WGRL/split-keyboard/Img/left_printed.pdf

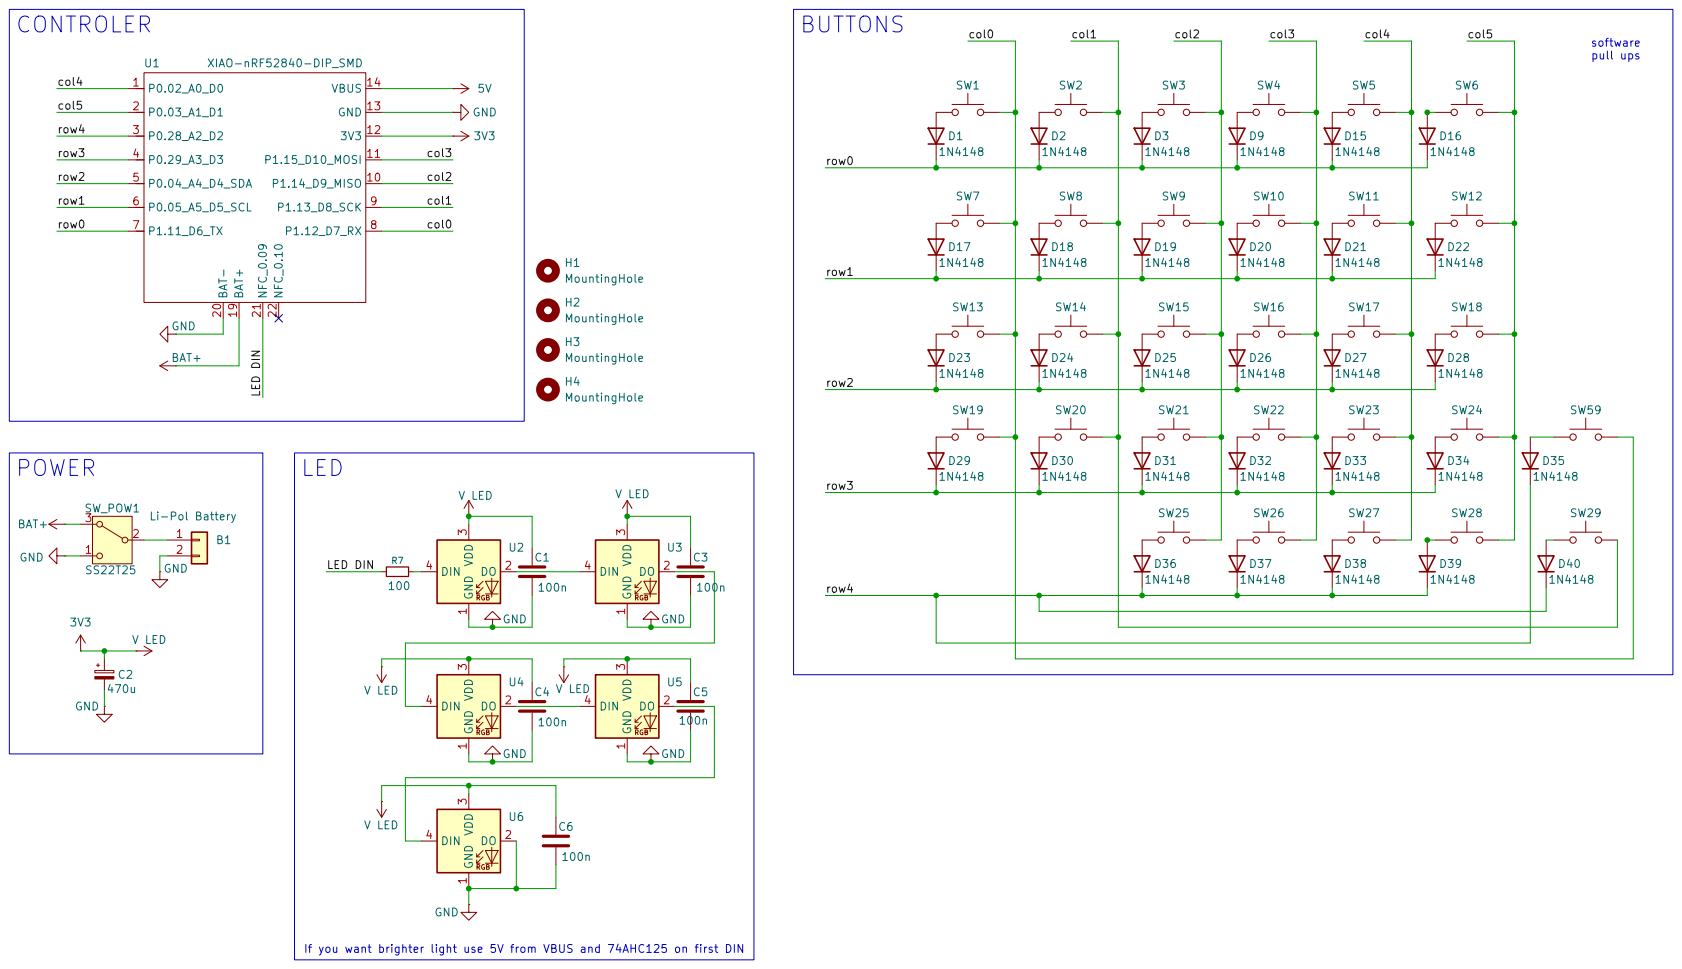
[picture p6: page 1]
