WGRL/split-keyboard/Img/right_printed.pdf

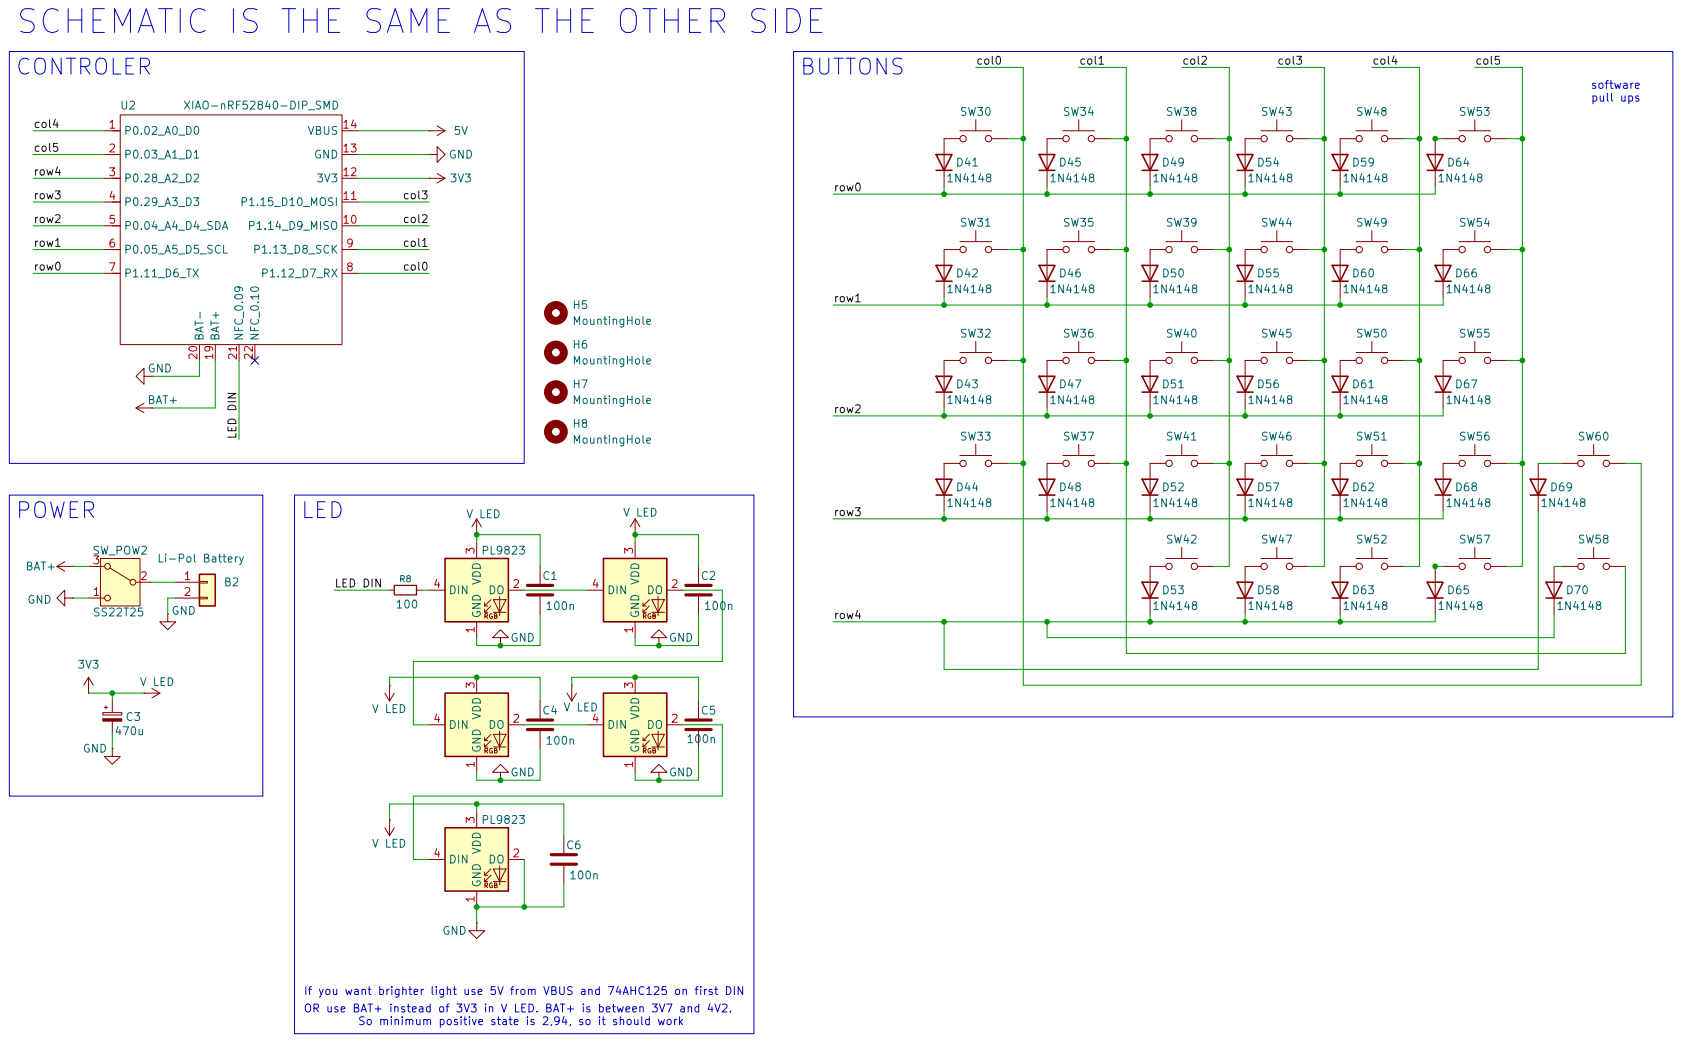
[picture p7: page 1]
