WGRL/split-keyboard/hardware_printed/right_side/right_side.kicad_pcb

## KiCad design hardware_printed/right_side/right_side.kicad_pcb (2026-10-13)

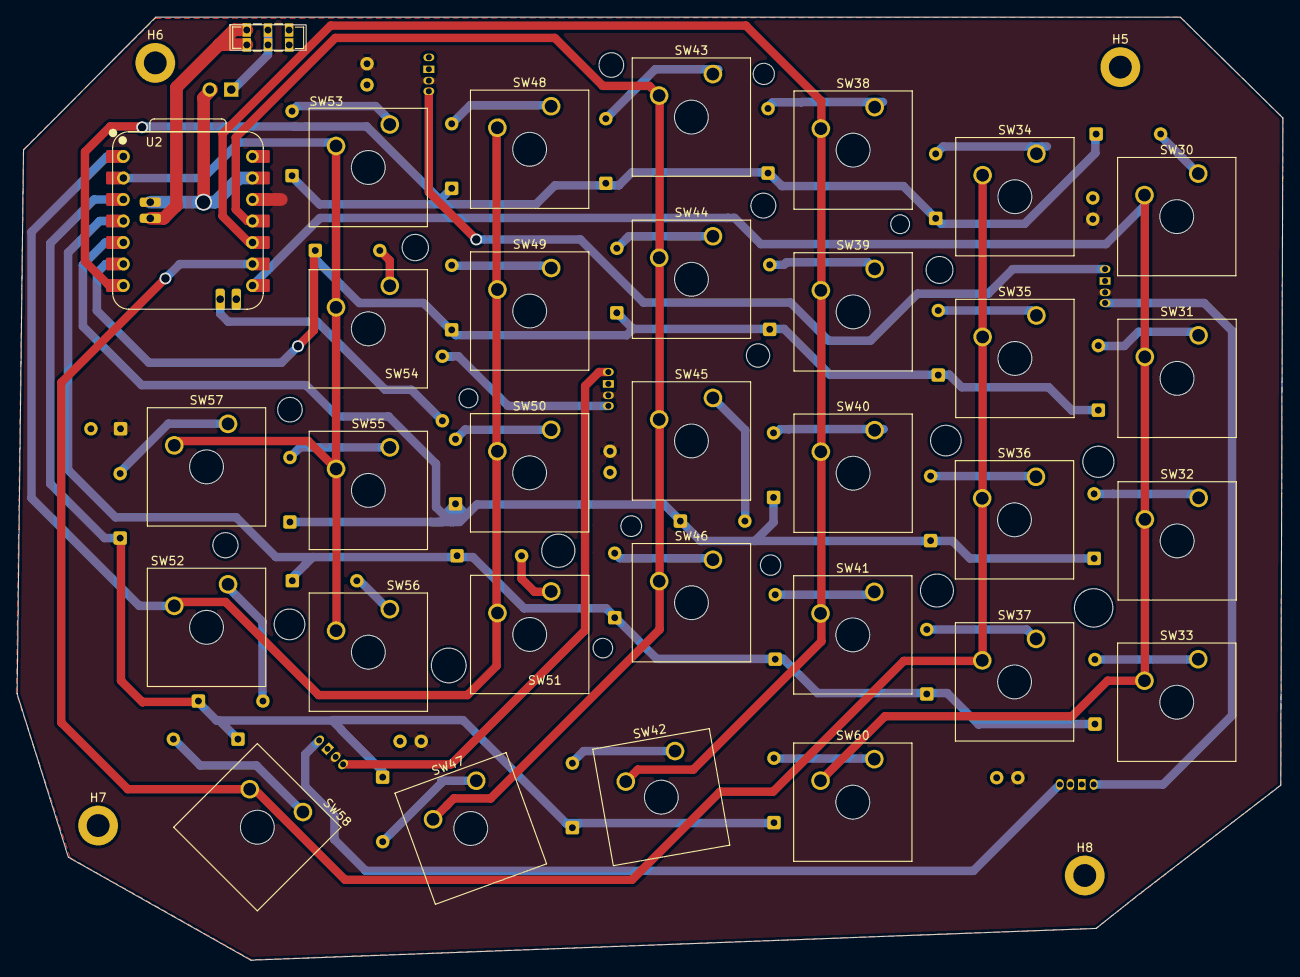
[picture p8: board right_side.kicad_pcb from above]

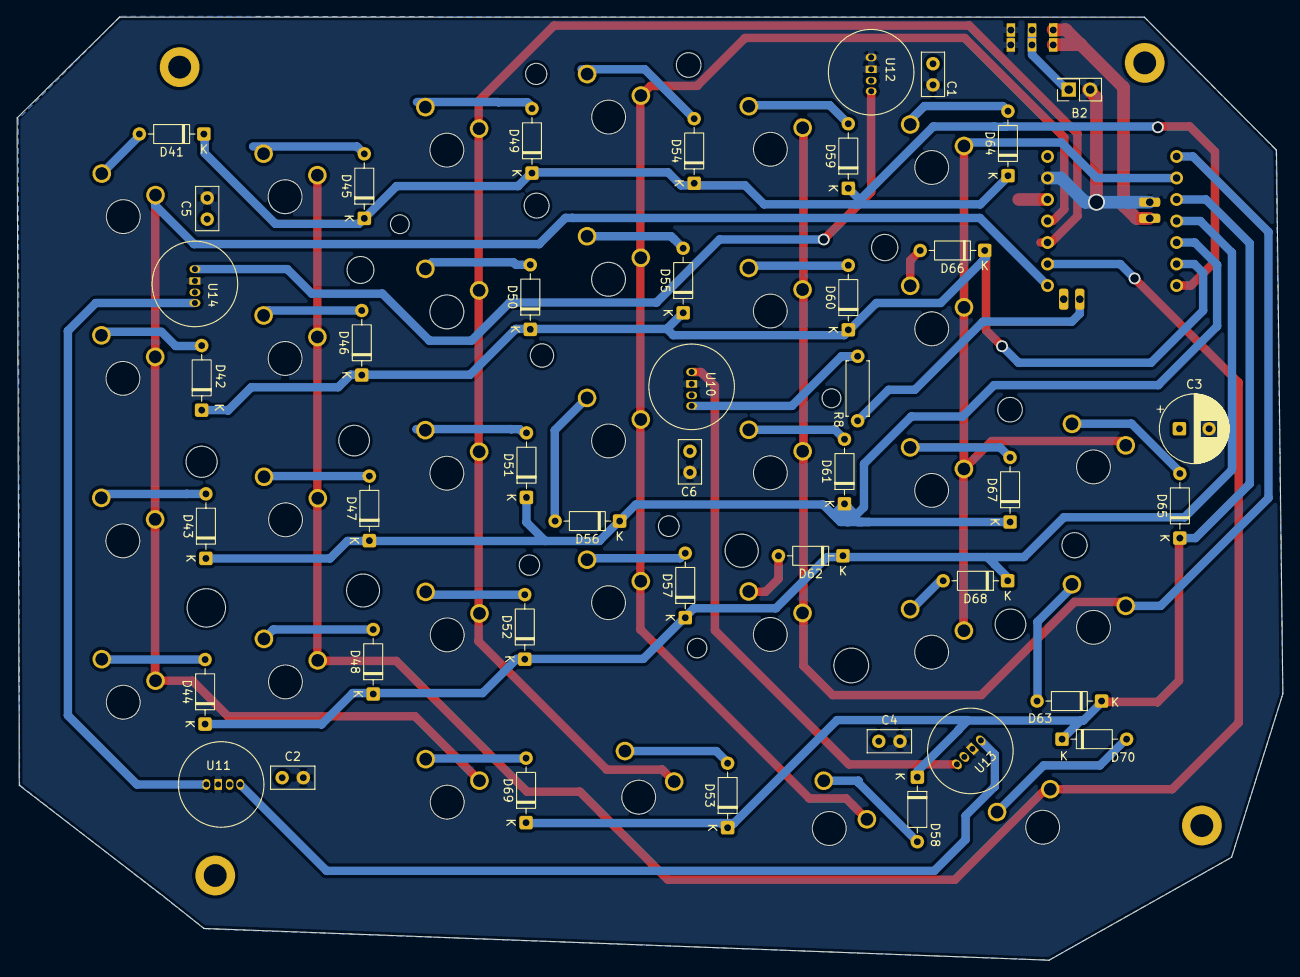
[picture p9: board right_side.kicad_pcb from below]

Board: 2 copper layers, 149.4 x 111.3 mm, 79 parts (43 on the bottom side), 51 nets.

Parts:
B2: Li-Pol Battery; PinSocket_2x01_P2.54mm_Vertical
C1, C2, C4, C5, C6: 100n; C_Disc_D5.0mm_W2.5mm_P2.50mm
C3: 470u; CP_Radial_D8.0mm_P3.50mm
D41, D42, D43, D44, D45, D46, D47, D48, D49, D50, D51, D52, D53, D54, D55, D56, D57, D58, D59, D60, D61, D62, D63, D64, D65, D66, D67, D68, D69, D70: 1N4148; D_DO-35_SOD27_P7.62mm_Horizontal
H5, H6, H7, H8: MountingHole; MountingHole_2.7mm_M2.5_DIN965_Pad
R8: 100; R_Axial_DIN0207_L6.3mm_D2.5mm_P7.62mm_Horizontal
SW30, SW31, SW32, SW33, SW34, SW35, SW36, SW37, SW38, SW39, SW40, SW41, SW42, SW43, SW44, SW45, SW46, SW47, SW48, SW49, SW50, SW51, SW52, SW53, SW54, SW55, SW56, SW57, SW58, SW60: SW_Push; SW_Cherry_MX_1.00u_Plate
SW_POW2: SS22T25; slider
U2: XIAO-nRF52840-DIP_SMD
U10, U11, U12, U13, U14: PL9823; PL9823-F8

Connections:
3V3: C1.1, C2.1, C3.1, C4.1, C5.1, C6.1, U2.12 (3V3), U10.3 (VDD), U11.3 (VDD), U12.3 (VDD), U13.3 (VDD), U14.3 (VDD)
/LED DIN: R8.1, U2.21 (NFC_0.09)
/col0: SW30.2, SW31.2, SW32.2, SW33.2, SW60.2, U2.8 (P1.12_D7_RX)
/col1: SW34.2, SW35.2, SW36.2, SW37.2, SW58.2, U2.9 (P1.13_D8_SCK)
/col2: SW38.2, SW39.2, SW40.2, SW41.2, SW42.2, U2.10 (P1.14_D9_MISO)
/col3: SW43.2, SW44.2, SW45.2, SW46.2, SW47.2, U2.11 (P1.15_D10_MOSI)
/col4: SW48.2, SW49.2, SW50.2, SW51.2, SW52.2, U2.1 (P0.02_A0_D0)
/col5: SW53.2, SW54.2, SW55.2, SW56.2, SW57.2, U2.2 (P0.03_A1_D1)
/row0: D41.1 (K), D45.1 (K), D49.1 (K), D54.1 (K), D59.1 (K), D64.1 (K), U2.7 (P1.11_D6_TX)
/row1: D42.1 (K), D46.1 (K), D50.1 (K), D55.1 (K), D60.1 (K), D66.1 (K), U2.6 (P0.05_A5_D5_SCL)
/row2: D43.1 (K), D47.1 (K), D51.1 (K), D56.1 (K), D61.1 (K), D67.1 (K), U2.5 (P0.04_A4_D4_SDA)
/row3: D44.1 (K), D48.1 (K), D52.1 (K), D57.1 (K), D62.1 (K), D68.1 (K), U2.4 (P0.29_A3_D3)
/row4: D53.1 (K), D58.1 (K), D63.1 (K), D65.1 (K), D69.1 (K), D70.1 (K), U2.3 (P0.28_A2_D2)
BAT+: SW_POW2.3 (A), U2.19 (BAT+)
GND: B2.2, C1.2, C2.2, C3.2, C4.2, C5.2, C6.2, SW_POW2.1 (C), U2.13 (GND), U2.20 (BAT-), U10.1 (GND), U11.1 (GND), U12.1 (GND), U12.2 (DO), U13.1 (GND), U14.1 (GND)
unnamed: B2.1, SW_POW2.2 (B)
unnamed: D41.2 (A), SW30.1
unnamed: D42.2 (A), SW31.1
unnamed: D43.2 (A), SW32.1
unnamed: D44.2 (A), SW33.1
unnamed: D45.2 (A), SW34.1
unnamed: D46.2 (A), SW35.1
unnamed: D47.2 (A), SW36.1
unnamed: D48.2 (A), SW37.1
unnamed: D49.2 (A), SW38.1
unnamed: D50.2 (A), SW39.1
unnamed: D51.2 (A), SW40.1
unnamed: D52.2 (A), SW41.1
unnamed: D53.2 (A), SW42.1
unnamed: D54.2 (A), SW43.1
unnamed: D55.2 (A), SW44.1
unnamed: D56.2 (A), SW45.1
unnamed: D57.2 (A), SW46.1
unnamed: D58.2 (A), SW47.1
unnamed: D59.2 (A), SW48.1
unnamed: D60.2 (A), SW49.1
unnamed: D61.2 (A), SW50.1
unnamed: D62.2 (A), SW51.1
unnamed: D63.2 (A), SW52.1
unnamed: D64.2 (A), SW53.1
unnamed: D65.2 (A), SW57.1
unnamed: D66.2 (A), SW54.1
unnamed: D67.2 (A), SW55.1
unnamed: D68.2 (A), SW56.1
unnamed: D69.2 (A), SW60.1
unnamed: D70.2 (A), SW58.1
unnamed: R8.2, U10.4 (DIN)
unnamed: U10.2 (DO), U13.4 (DIN)
unnamed: U11.4 (DIN), U13.2 (DO)
unnamed: U11.2 (DO), U14.4 (DIN)
unnamed: U12.4 (DIN), U14.2 (DO)
