WGRL/split-keyboard/hardware/left_side/left_side.kicad_sch

## KiCad design hardware/left_side/left_side.kicad_sch (2026-10-13)

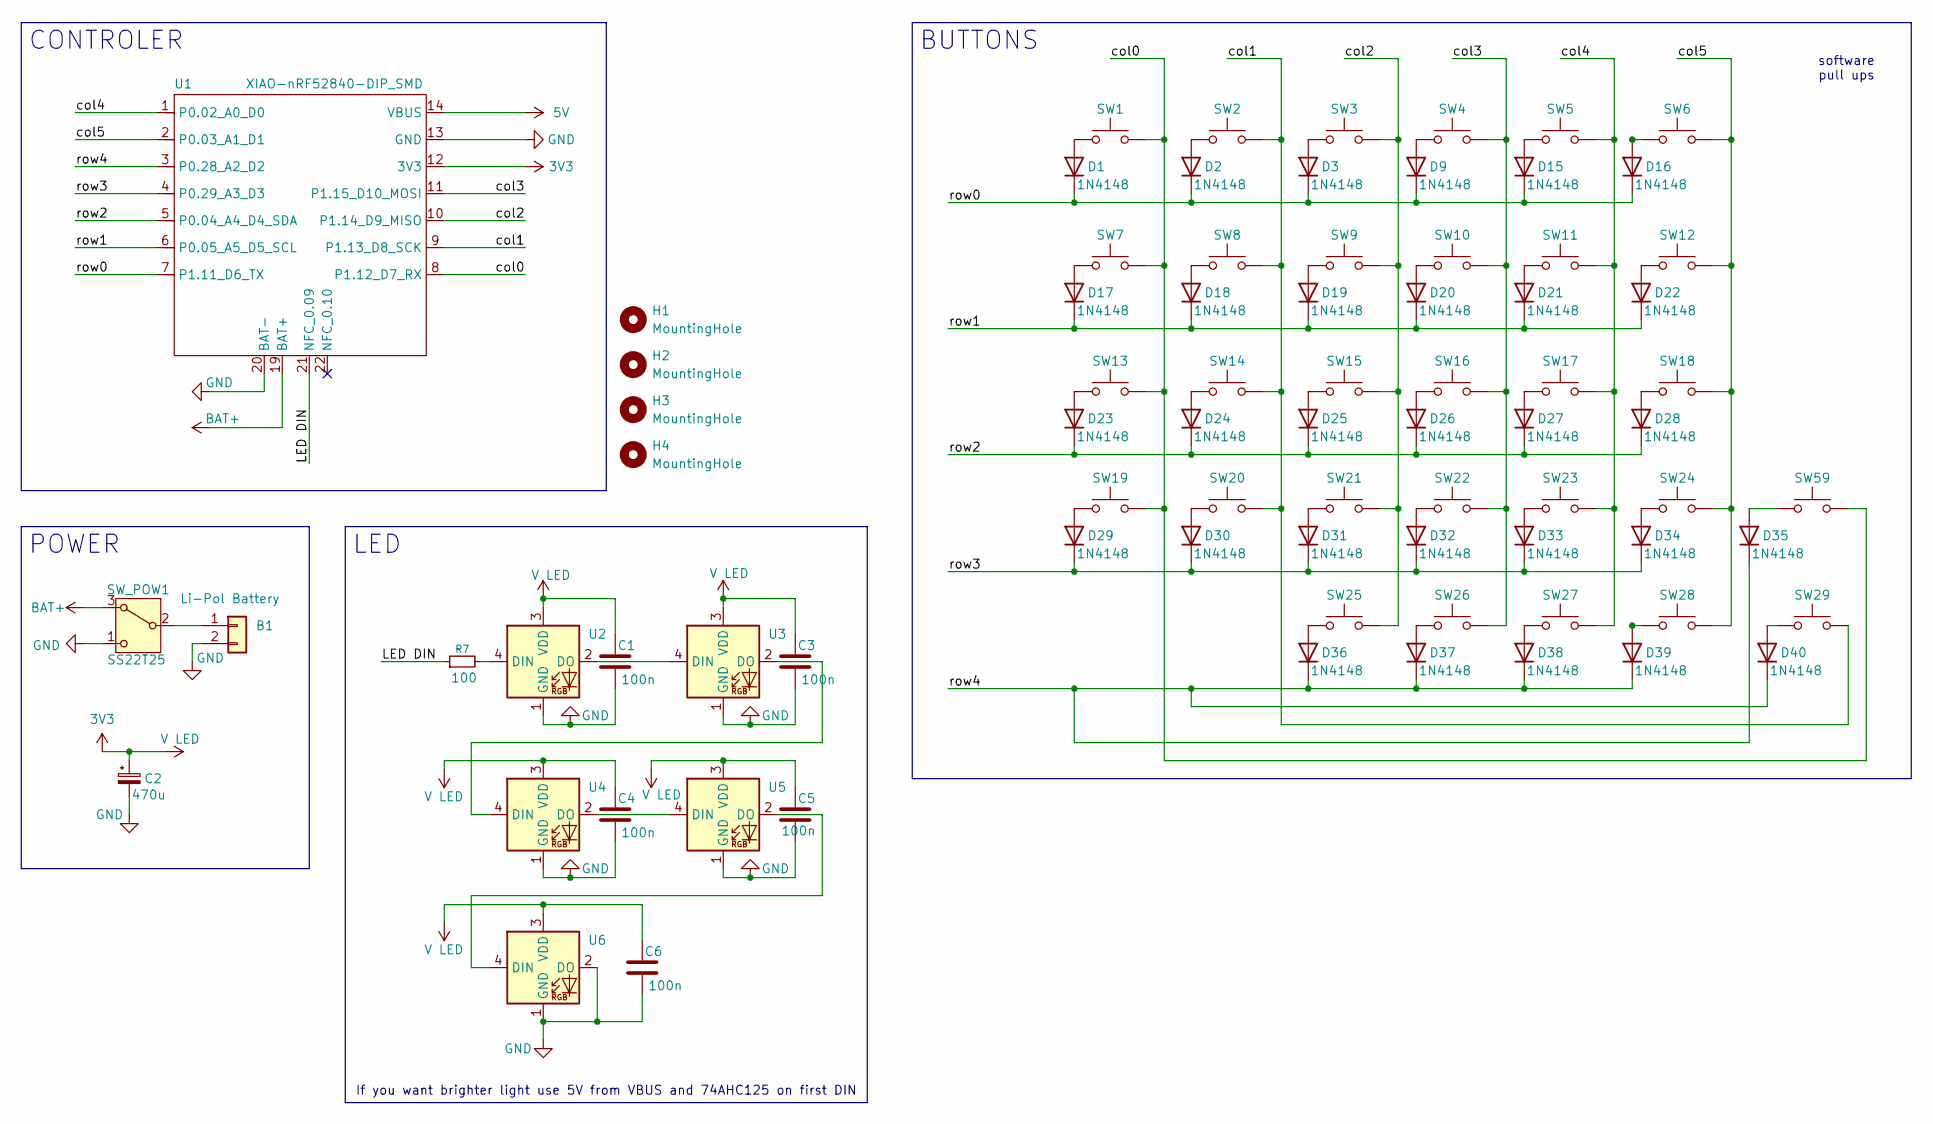
[picture p10: schematic left_side.kicad_sch]

Parts:
B1: Li-Pol Battery; PinSocket_2x01_P2.54mm_Vertical
C1, C3, C4, C5, C6: 100n; C_Disc_D5.0mm_W2.5mm_P2.50mm
C2: 470u; CP_Radial_D8.0mm_P3.50mm
D1, D2, D3, D9, D15, D16, D17, D18, D19, D20, D21, D22, D23, D24, D25, D26, D27, D28, D29, D30, D31, D32, D33, D34, D35, D36, D37, D38, D39, D40: 1N4148; D_DO-35_SOD27_P7.62mm_Horizontal
H1, H2, H3, H4: MountingHole; MountingHole_2.7mm_M2.5_DIN965_Pad
R7: 100; R_Axial_DIN0207_L6.3mm_D2.5mm_P7.62mm_Horizontal
SW1, SW2, SW3, SW4, SW5, SW6, SW7, SW8, SW9, SW10, SW11, SW12, SW13, SW14, SW15, SW16, SW17, SW18, SW19, SW20, SW21, SW22, SW23, SW24, SW25, SW26, SW27, SW28, SW29, SW59: SW_Push; SW_Cherry_MX_1.00u_Plate
SW_POW1: SS22T25; slider
U1: XIAO-nRF52840-DIP_SMD
U2, U3, U4, U5, U6: PL9823-F8

Connections:
3V3: C1.1, C2.1, C3.1, C4.1, C5.1, C6.1, U1.12 (3V3), U2.3 (VDD), U3.3 (VDD), U4.3 (VDD), U5.3 (VDD), U6.3 (VDD)
5V: U1.14 (VBUS)
BAT+: SW_POW1.3 (A), U1.19 (BAT+)
GND: B1.2, C1.2, C2.2, C3.2, C4.2, C5.2, C6.2, SW_POW1.1 (C), U1.13 (GND), U1.20 (BAT-), U2.1 (GND), U3.1 (GND), U4.1 (GND), U5.1 (GND), U6.1 (GND), U6.2 (DO)
LED DIN: R7.1, U1.21 (NFC_0.09)
unnamed: B1.1, SW_POW1.2 (B)
unnamed: D1.2 (A), SW1.1
unnamed: D2.2 (A), SW2.1
unnamed: D3.2 (A), SW3.1
unnamed: D9.2 (A), SW4.1
unnamed: D15.2 (A), SW5.1
unnamed: D16.2 (A), SW6.1
unnamed: D17.2 (A), SW7.1
unnamed: D18.2 (A), SW8.1
unnamed: D19.2 (A), SW9.1
unnamed: D20.2 (A), SW10.1
unnamed: D21.2 (A), SW11.1
unnamed: D22.2 (A), SW12.1
unnamed: D23.2 (A), SW13.1
unnamed: D24.2 (A), SW14.1
unnamed: D25.2 (A), SW15.1
unnamed: D26.2 (A), SW16.1
unnamed: D27.2 (A), SW17.1
unnamed: D28.2 (A), SW18.1
unnamed: D29.2 (A), SW19.1
unnamed: D30.2 (A), SW20.1
unnamed: D31.2 (A), SW21.1
unnamed: D32.2 (A), SW22.1
unnamed: D33.2 (A), SW23.1
unnamed: D34.2 (A), SW24.1
unnamed: D35.2 (A), SW59.1
unnamed: D36.2 (A), SW25.1
unnamed: D37.2 (A), SW26.1
unnamed: D38.2 (A), SW27.1
unnamed: D39.2 (A), SW28.1
unnamed: D40.2 (A), SW29.1
unnamed: R7.2, U2.4 (DIN)
unnamed: U2.2 (DO), U3.4 (DIN)
unnamed: U3.2 (DO), U4.4 (DIN)
unnamed: U4.2 (DO), U5.4 (DIN)
unnamed: U5.2 (DO), U6.4 (DIN)
col0: SW1.2, SW7.2, SW13.2, SW19.2, SW59.2, U1.8 (P1.12_D7_RX)
col1: SW2.2, SW8.2, SW14.2, SW20.2, SW29.2, U1.9 (P1.13_D8_SCK)
col2: SW3.2, SW9.2, SW15.2, SW21.2, SW25.2, U1.10 (P1.14_D9_MISO)
col3: SW4.2, SW10.2, SW16.2, SW22.2, SW26.2, U1.11 (P1.15_D10_MOSI)
col4: SW5.2, SW11.2, SW17.2, SW23.2, SW27.2, U1.1 (P0.02_A0_D0)
col5: SW6.2, SW12.2, SW18.2, SW24.2, SW28.2, U1.2 (P0.03_A1_D1)
row0: D1.1 (K), D2.1 (K), D3.1 (K), D9.1 (K), D15.1 (K), D16.1 (K), U1.7 (P1.11_D6_TX)
row1: D17.1 (K), D18.1 (K), D19.1 (K), D20.1 (K), D21.1 (K), D22.1 (K), U1.6 (P0.05_A5_D5_SCL)
row2: D23.1 (K), D24.1 (K), D25.1 (K), D26.1 (K), D27.1 (K), D28.1 (K), U1.5 (P0.04_A4_D4_SDA)
row3: D29.1 (K), D30.1 (K), D31.1 (K), D32.1 (K), D33.1 (K), D34.1 (K), U1.4 (P0.29_A3_D3)
row4: D35.1 (K), D36.1 (K), D37.1 (K), D38.1 (K), D39.1 (K), D40.1 (K), U1.3 (P0.28_A2_D2)

Notes on the sheet:
software pull ups
If you want brighter light use 5V from VBUS and 74AHC125 on first DIN
CONTROLER
POWER
LED
BUTTONS
