WGRL/split-keyboard/(commit log)

2026-10-13 Initial commit. Leds not yet implemented.
2026-10-13 Update image link to use preview for schematics
2026-10-13 Revise PCB file locations and add usage notes
    Updated directory references for PCB files and added notes on board limitations.
